Pilperi/sienimittari/pcb/sienikontrolleri/sienikontrolleri.kicad_pcb

## KiCad design pcb/sienikontrolleri/sienikontrolleri.kicad_pcb (2024-11-15, last stored version)

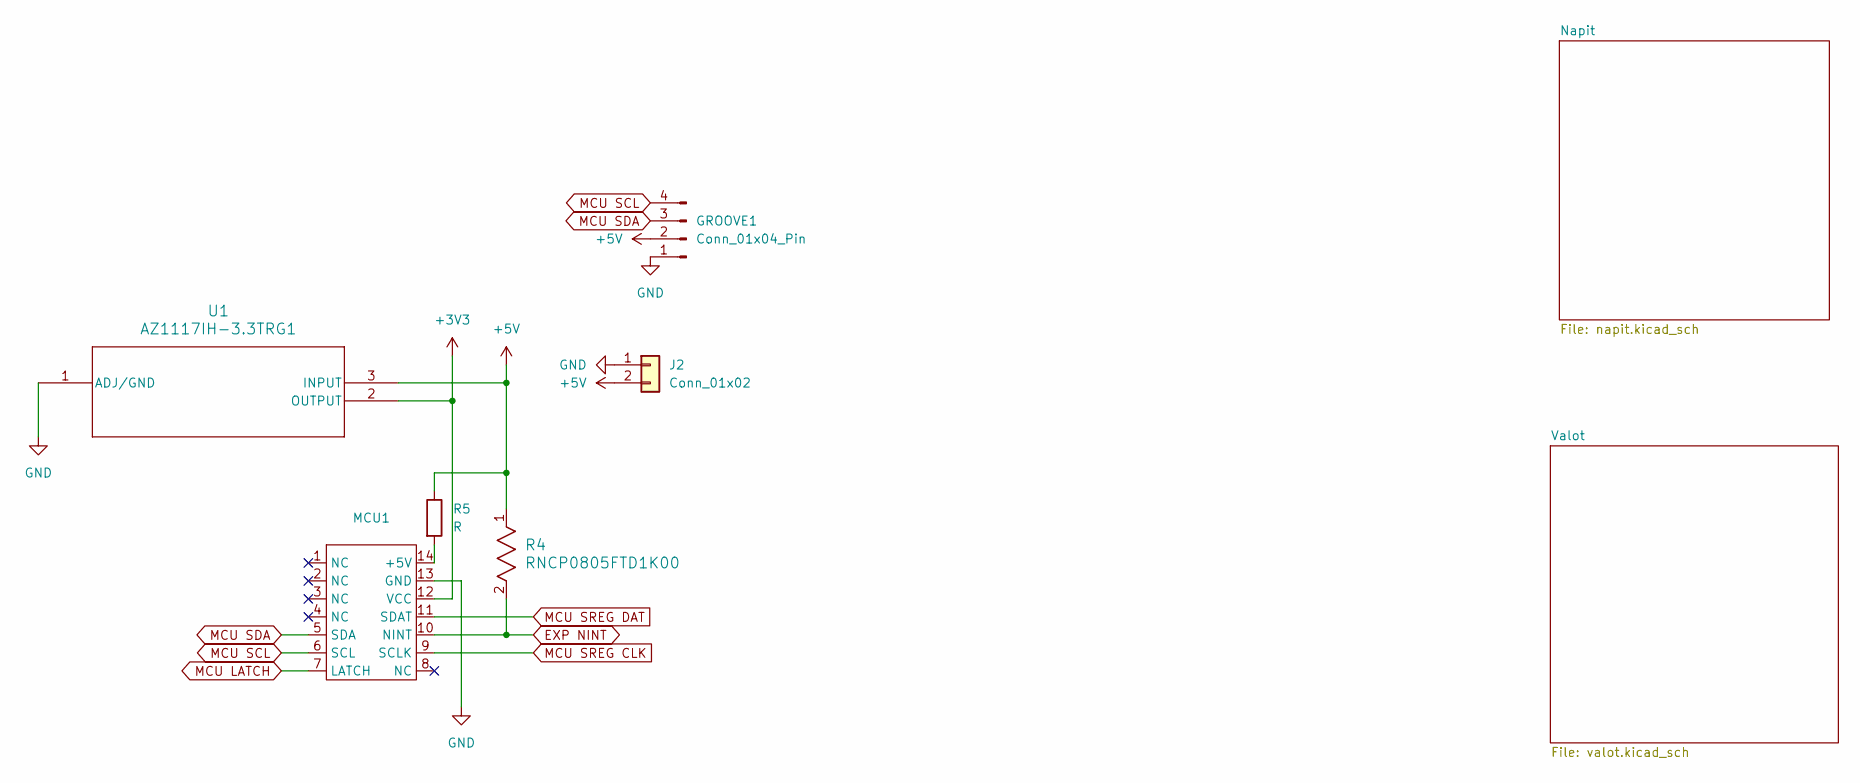
[picture p4: schematic sienikontrolleri.kicad_sch]

Parts:
GROOVE1: Conn_01x04_Pin; PinHeader_1x04_P2.00mm_Vertical
J2: Conn_01x02; PinHeader_1x02_P2.54mm_Vertical
MCU1: MCU 14
R4: RNCP0805FTD1K00; STA_RNCP0805_STP
R5: R; R_0805_2012Metric_Pad1.20x1.40mm_HandSolder
U1: AZ1117IH-3.3TRG1; SOT223_AZ1117I_6P5X3P5_DIO

Connections:
+3V3: MCU1.12 (VCC), U1.2 (OUTPUT)
+5V: GROOVE1.2, J2.2, R4.1, R5.1, U1.3 (INPUT); also elsewhere on the board
EXP NINT: MCU1.10 (NINT), R4.2; also elsewhere on the board
GND: GROOVE1.1, J2.1, MCU1.13 (GND), U1.1 (ADJ/GND); also elsewhere on the board
MCU LATCH: MCU1.7 (LATCH); also elsewhere on the board
MCU SCL: GROOVE1.4, MCU1.6 (SCL); also elsewhere on the board
MCU SDA: GROOVE1.3, MCU1.5 (SDA); also elsewhere on the board
MCU SREG CLK: MCU1.9 (SCLK); also elsewhere on the board
MCU SREG DAT: MCU1.11 (SDAT); also elsewhere on the board
unnamed: MCU1.14 (+5V), R5.2

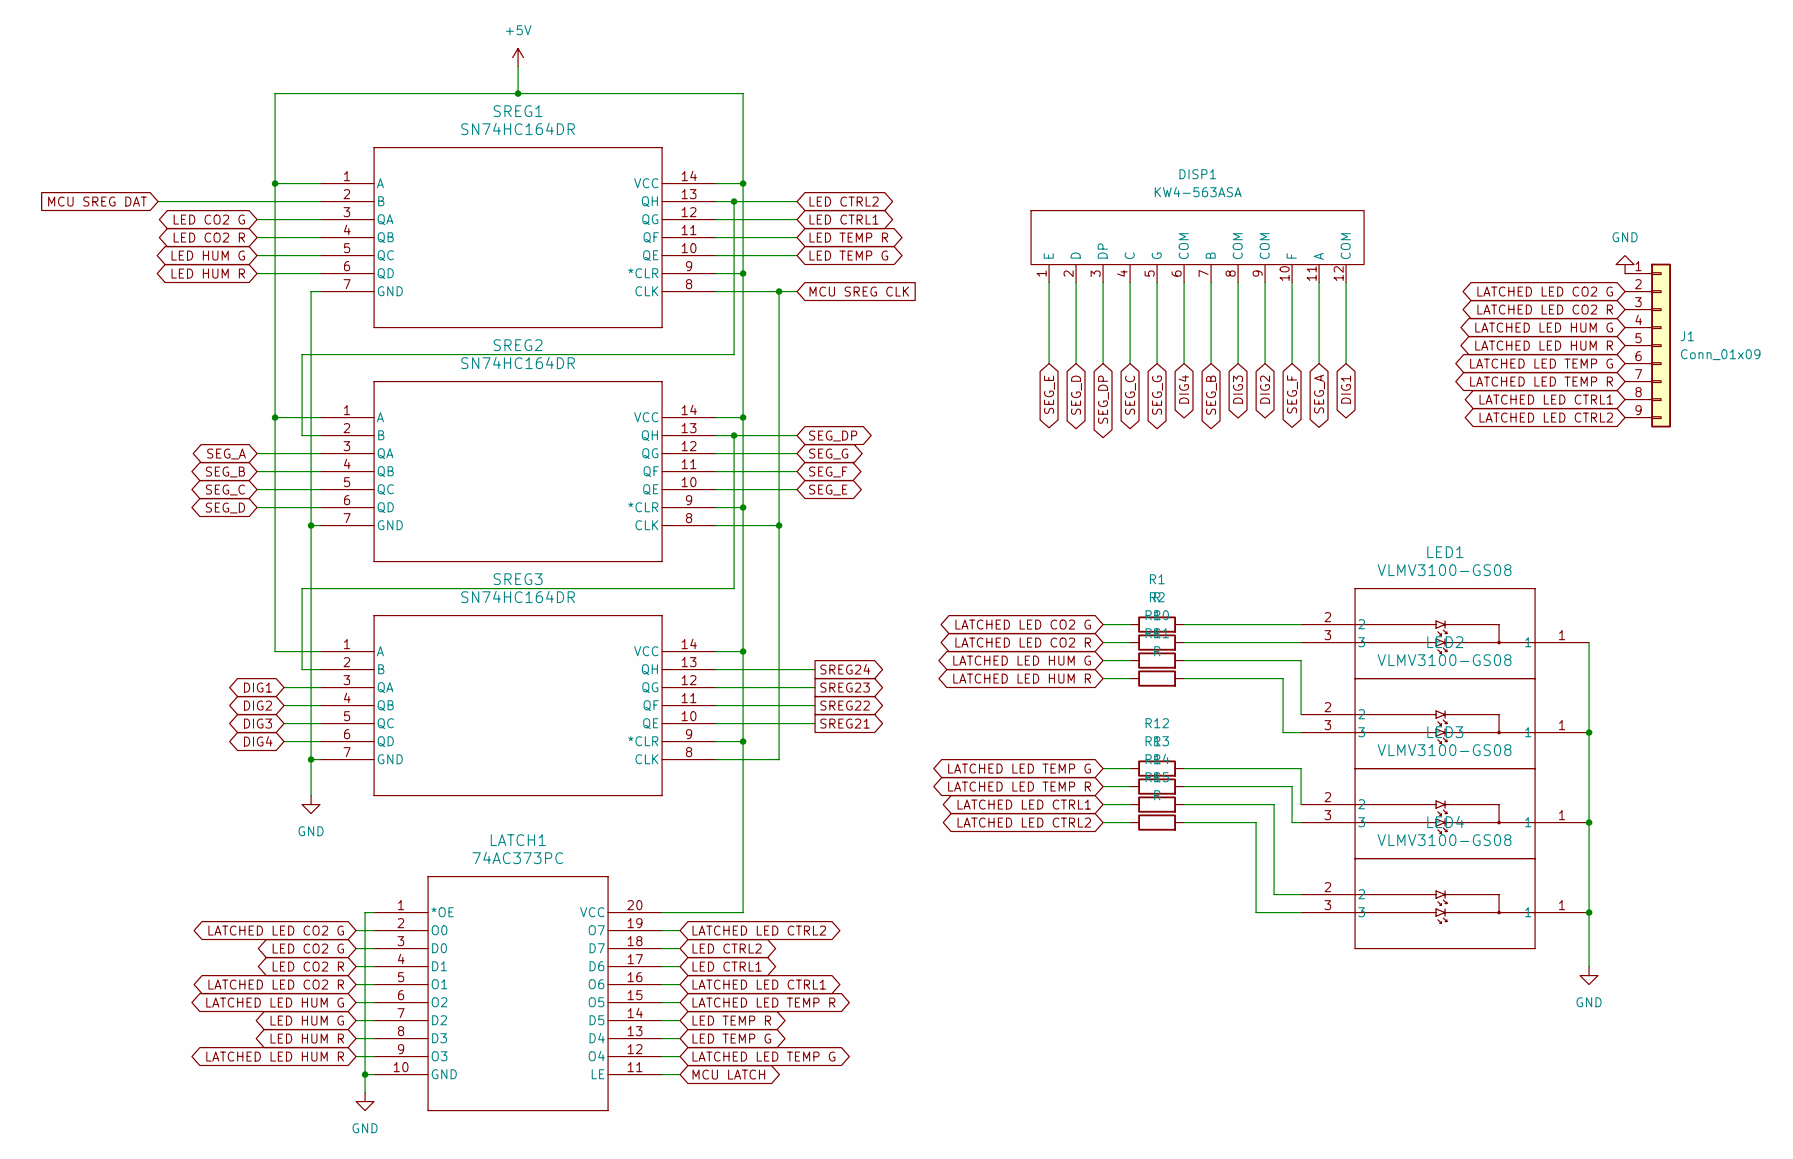
[picture p5: schematic valot.kicad_sch]

Parts:
DISP1: KW4-563ASA
J1: Conn_01x09; PinHeader_1x09_P2.54mm_Vertical
LATCH1: 74AC373PC; PDIP20_26P42X6P6_ONS
LED1, LED2, LED3, LED4: VLMV3100-GS08; VLMV3100_VIS
R1, R2, R10, R11, R12, R13, R14, R15: R; R_0805_2012Metric_Pad1.20x1.40mm_HandSolder
SREG1, SREG2, SREG3: SN74HC164DR; D14

Connections:
+5V: LATCH1.20 (VCC), SREG1.1 (A), SREG1.9 (*CLR), SREG1.14 (VCC), SREG2.1 (A), SREG2.9 (*CLR), SREG2.14 (VCC), SREG3.1 (A), SREG3.9 (*CLR), SREG3.14 (VCC); also elsewhere on the board
DIG1: DISP1.12 (COM), SREG3.3 (QA)
DIG2: DISP1.9 (COM), SREG3.4 (QB)
DIG3: DISP1.8 (COM), SREG3.5 (QC)
DIG4: DISP1.6 (COM), SREG3.6 (QD)
GND: J1.1, LATCH1.1 (*OE), LATCH1.10 (GND), LED1.1, LED2.1, LED3.1, LED4.1, SREG1.7 (GND), SREG2.7 (GND), SREG3.7 (GND); also elsewhere on the board
LATCHED LED CO2 G: J1.2, LATCH1.2 (O0), R1.1
LATCHED LED CO2 R: J1.3, LATCH1.5 (O1), R2.1
LATCHED LED CTRL1: J1.8, LATCH1.16 (O6), R14.1
LATCHED LED CTRL2: J1.9, LATCH1.19 (O7), R15.1
LATCHED LED HUM G: J1.4, LATCH1.6 (O2), R10.1
LATCHED LED HUM R: J1.5, LATCH1.9 (O3), R11.1
LATCHED LED TEMP G: J1.6, LATCH1.12 (O4), R12.1
LATCHED LED TEMP R: J1.7, LATCH1.15 (O5), R13.1
LED CO2 G: LATCH1.3 (D0), SREG1.3 (QA)
LED CO2 R: LATCH1.4 (D1), SREG1.4 (QB)
LED CTRL1: LATCH1.17 (D6), SREG1.12 (QG)
LED CTRL2: LATCH1.18 (D7), SREG1.13 (QH), SREG2.2 (B)
LED HUM G: LATCH1.7 (D2), SREG1.5 (QC)
LED HUM R: LATCH1.8 (D3), SREG1.6 (QD)
LED TEMP G: LATCH1.13 (D4), SREG1.10 (QE)
LED TEMP R: LATCH1.14 (D5), SREG1.11 (QF)
MCU LATCH: LATCH1.11 (LE); also elsewhere on the board
MCU SREG CLK: SREG1.8 (CLK), SREG2.8 (CLK), SREG3.8 (CLK); also elsewhere on the board
MCU SREG DAT: SREG1.2 (B); also elsewhere on the board
unnamed: LED1.2, R1.2
unnamed: LED1.3, R2.2
unnamed: LED2.2, R10.2
unnamed: LED2.3, R11.2
unnamed: LED3.2, R12.2
unnamed: LED3.3, R13.2
unnamed: LED4.2, R14.2
unnamed: LED4.3, R15.2
SEG_A: DISP1.11 (A), SREG2.3 (QA)
SEG_B: DISP1.7 (B), SREG2.4 (QB)
SEG_C: DISP1.4 (C), SREG2.5 (QC)
SEG_D: DISP1.2 (D), SREG2.6 (QD)
SEG_DP: DISP1.3 (DP), SREG2.13 (QH), SREG3.2 (B)
SEG_E: DISP1.1 (E), SREG2.10 (QE)
SEG_F: DISP1.10 (F), SREG2.11 (QF)
SEG_G: DISP1.5 (G), SREG2.12 (QG)
SREG21: SREG3.10 (QE)
SREG22: SREG3.11 (QF)
SREG23: SREG3.12 (QG)
SREG24: SREG3.13 (QH)

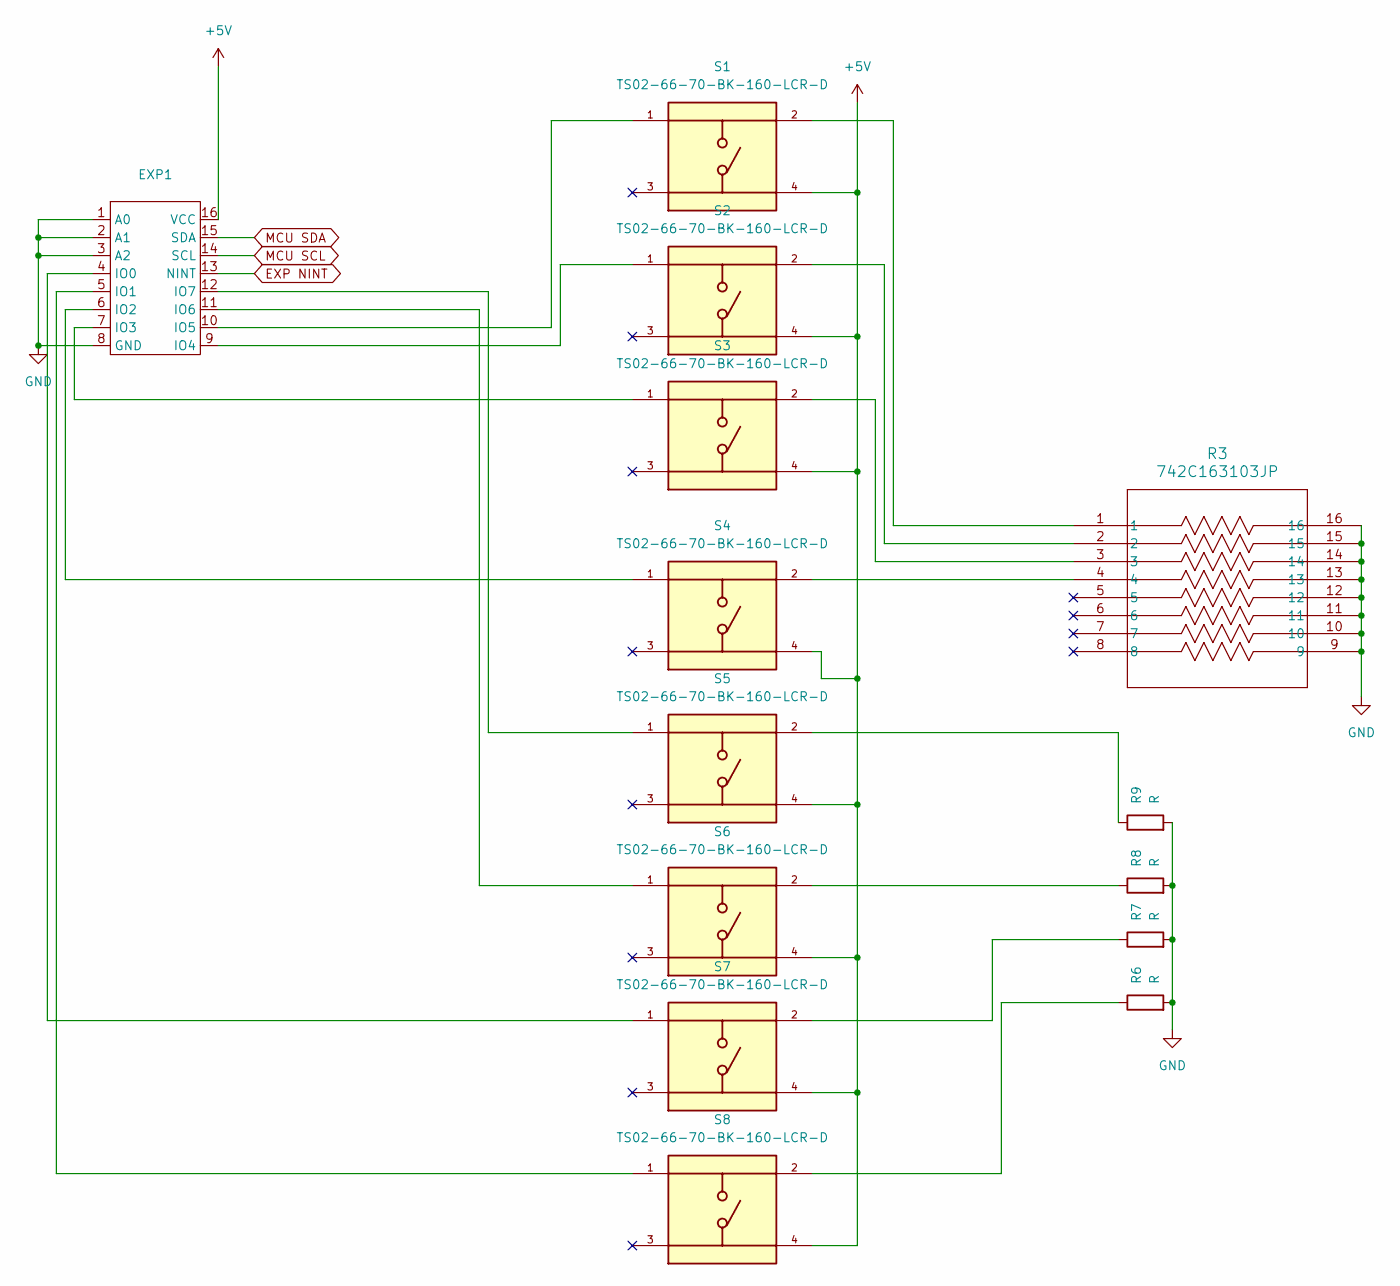
[picture p6: schematic napit.kicad_sch]

Parts:
EXP1: TSSOP-16_4.4x5mm_P0.65mm
R3: 742C163103JP; RES_CTS74X_6P4X1P6_CTS
R6, R7, R8, R9: R; R_0805_2012Metric_Pad1.20x1.40mm_HandSolder
S1, S2, S3, S4, S5, S6, S7, S8: TS02-66-70-BK-160-LCR-D; SW_TS02-66-70-BK-160-LCR-D; PARTREV 1.0

Connections:
+5V: EXP1.16 (VCC), S1.4, S2.4, S3.4, S4.4, S5.4, S6.4, S7.4, S8.4; also elsewhere on the board
EXP NINT: EXP1.13 (NINT); also elsewhere on the board
GND: EXP1.1 (A0), EXP1.2 (A1), EXP1.3 (A2), EXP1.8 (GND), R3.9, R3.10, R3.11, R3.12, R3.13, R3.14, R3.15, R3.16, R6.2, R7.2, R8.2, R9.2; also elsewhere on the board
MCU SCL: EXP1.14 (SCL); also elsewhere on the board
MCU SDA: EXP1.15 (SDA); also elsewhere on the board
unnamed: EXP1.4 (IO0), S7.1
unnamed: EXP1.5 (IO1), S8.1
unnamed: EXP1.6 (IO2), S4.1
unnamed: EXP1.7 (IO3), S3.1
unnamed: EXP1.9 (IO4), S2.1
unnamed: EXP1.10 (IO5), S1.1
unnamed: EXP1.11 (IO6), S6.1
unnamed: EXP1.12 (IO7), S5.1
unnamed: R3.1, S1.2
unnamed: R3.2, S2.2
unnamed: R3.3, S3.2
unnamed: R3.4, S4.2
unnamed: R6.1, S8.2
unnamed: R7.1, S7.2
unnamed: R8.1, S6.2
unnamed: R9.1, S5.2

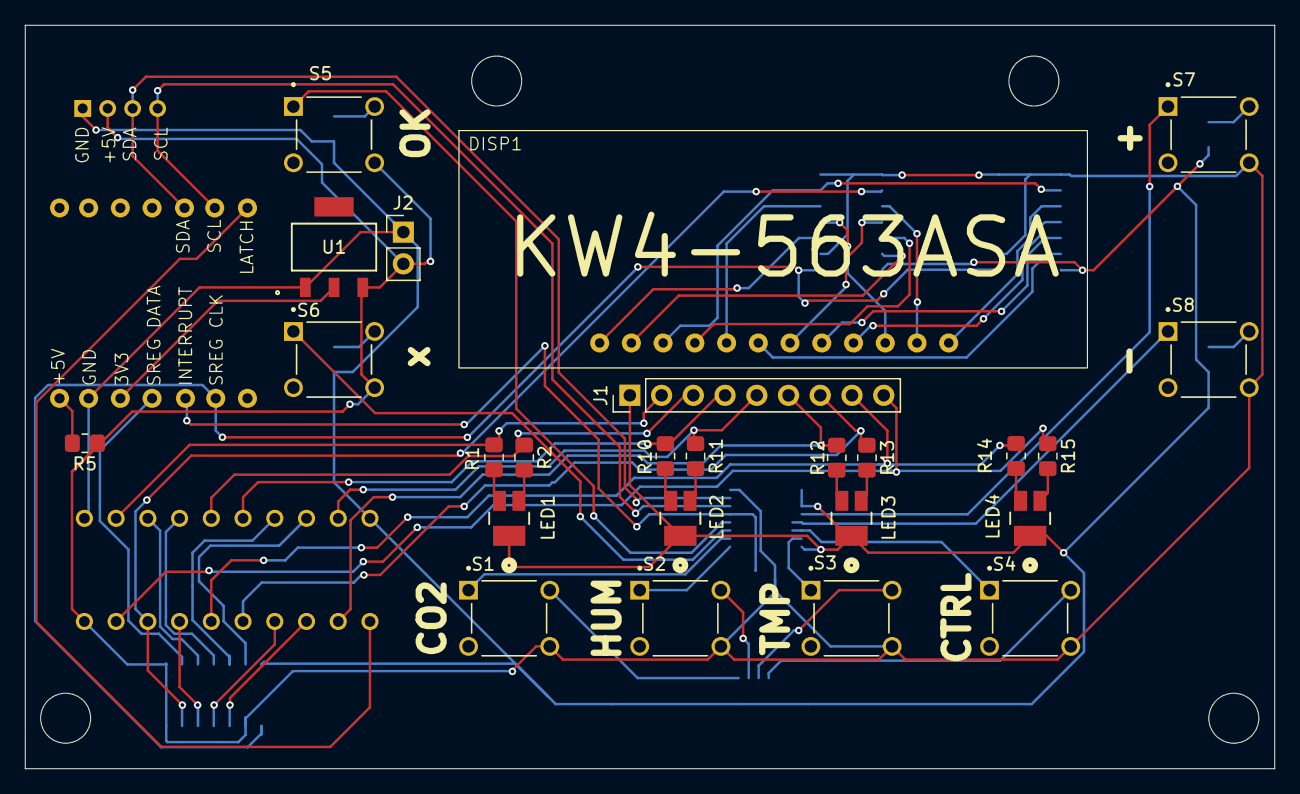
[picture p7: board sienikontrolleri.kicad_pcb from above]

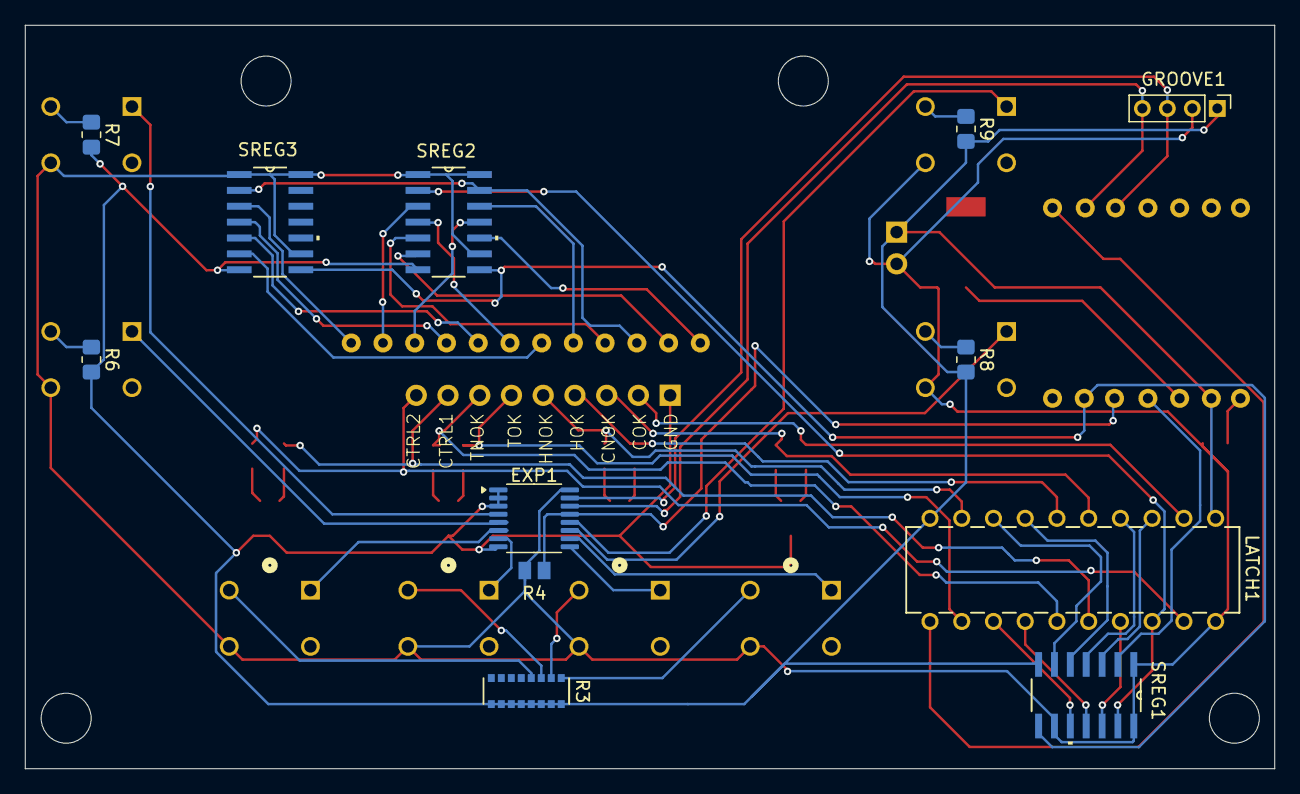
[picture p8: board sienikontrolleri.kicad_pcb from below]

Board: 2 copper layers, 100.0 x 59.5 mm, 38 parts (13 on the bottom side), 62 nets.
