Pilperi/sienimittari/co2_mittasystem/co2_mittasystem.ino

#include <Arduino.h>
#include <stdlib.h>
#include <stdint.h>
#include <Wire.h>
#include "co2_datatyypit.hpp"
#include "co2_pinnit.hpp"
#include "co2_kommunikointi.hpp"
#include "co2_ioexp.hpp"
#include "co2_ui.hpp"
#include "co2_napit.hpp"
#include "co2_yksikkotestit.hpp"

#define SENSORI 1

// SCD4x
const int16_t SCD_ADDRESS = 0x62;



/* Testimoodi, katso toimiiko kaikki */
void testi(){
    viesti_t* viesti = uusi_viesti();
    testaa_statusvalot(viesti);
    testaa_segmentit(viesti);
    testaa_numerokentat(viesti);
    testaa_numerotulostus(viesti);
    // Valmis
    tuhoa_viesti(viesti);
    return;
}

void setup() {
    aseta_pinnitilat();
    if(SENSORI){
        // I2C alustus
        Wire.begin();
        // Odotetaan sensoria
        delay(1000);
        // Periodisen mittauksen aloitus, mittapiste 5 s välein
        Wire.beginTransmission(SCD_ADDRESS);
        Wire.write(0x21);
        Wire.write(0xb1);
        Wire.endTransmission();

        // Odotetaan ensimmäistä mittausta, tehdään vaikka testi odotellessa
        testi();
    }
}


void loop() {
    /* Testimoodi */
    if(!SENSORI){
        while(1){
            testi();
        }
    }
    
    /* Normaalimoodi */
    unsigned char painettu_nappi;
    ioexp_porttisuunta(0xFF); // kaikki sisääntuloja
    ioexp_out(0x00);
    painettu_nappi = ioexp_lue();
    /* Oletusrajat */
    rajat_t* rajat = uudet_rajat();

    viesti_t* viesti = uusi_viesti();
    
    // Tulos- ja statuswrapperi
    mittatulos_t* mittatulos = uusi_mittatulos();
    
    uint16_t moodi = MOODI_NORMAALI;
    
    uint8_t data_in[12], laskuri;
    uint16_t aikaa;
    while(1){
      // Pyydä mittaustulosta
      Wire.beginTransmission(SCD_ADDRESS);
      Wire.write(0xec);
      Wire.write(0x05);
      Wire.endTransmission();

      // Lue data sensorilta
      Wire.requestFrom(SCD_ADDRESS, 12);
      laskuri = 0;
      while (Wire.available()) {
          data_in[laskuri++] = Wire.read();
      }
      // Tulokset inee
      paivita_mittatulos(mittatulos, data_in);
      paivita_mittastatus(mittatulos, rajat);
      paivita_valot_viestiin(mittatulos, viesti);
  
      tulosta_valot(viesti);
      aikaa = 0;
      while(aikaa < 5000){
        if(digitalRead(INTERRUPT) == LOW){
            painettu_nappi = ioexp_lue();
            moodi = tulkitse_painallus(painettu_nappi, moodi);
        }
        if(moodi & (MOODI_CO2|MOODI_KOSTEUS|MOODI_LAMPOTILA)){
          ui_mainflow(moodi, viesti, mittatulos, rajat, &aikaa);
          }
        //aikaa += tulosta_lukua(1234, viesti, 2000);
        delay(1);
        aikaa++;
    }
    }
    tuhoa_viesti(viesti);
    tuhoa_mittatulos(mittatulos);
    tuhoa_rajat(rajat);
 }
