Pilperi/sienimittari/(commit log)

2024-11-15 Lisää PCB
    [napit.kicad_sch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]
2024-11-23 Tuunaa koodi vastaamaan tilattua PCB:tä (piuhoituksia tarvitsi muuttaa)
2024-11-23 Poista PCB-kansiosta kaikki turha
    [napit.kicad_sch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]
2024-11-23 Laita nappimääritykset vastaamaan PCB:tä
2024-11-23 Lisää PCB:n skeema-PDF
